PaulvanderVleuten/boss-me-90-wireless-ble-midi-patch-and-preset-display/enclosure/enclosure box.stl

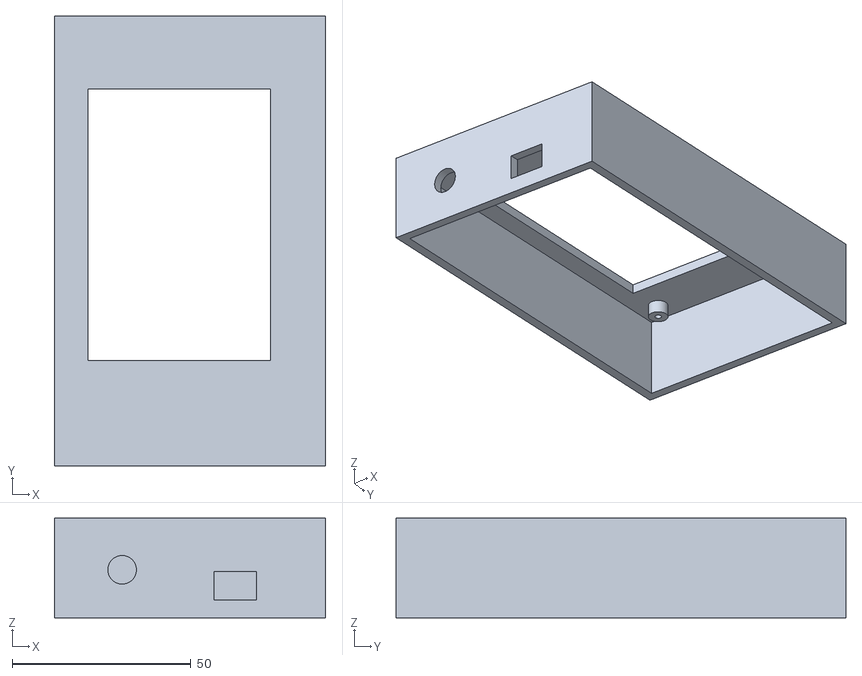
[picture p5: CAD file, 2026-11-03]
enclosure/enclosure box.stl
76.0 x 126.0 x 28.0
