PaulvanderVleuten/boss-me-90-wireless-ble-midi-patch-and-preset-display/enclosure/enclosure lid.stl

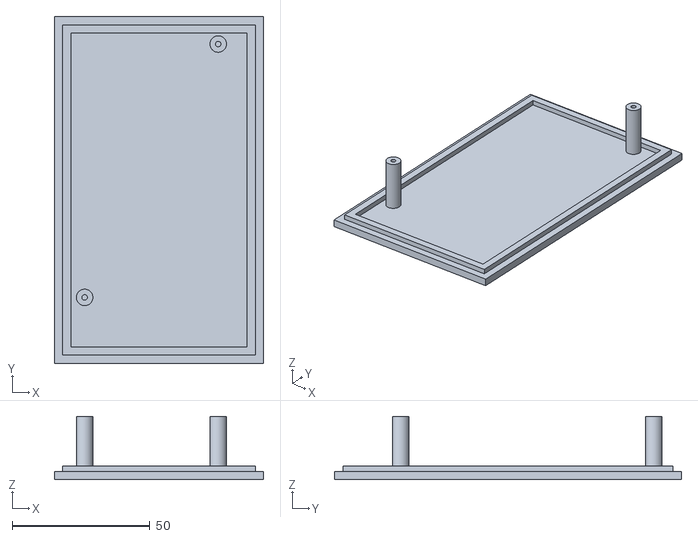
[picture p6: CAD file, 2026-11-03]
enclosure/enclosure lid.stl
76.0 x 126.0 x 23.0
