PaulvanderVleuten/boss-me-90-wireless-ble-midi-patch-and-preset-display/(notices)

Notices in the files:
README.md:
License: MIT
